blazic016/CNC_ploter/3D print/anti-basculement.stl

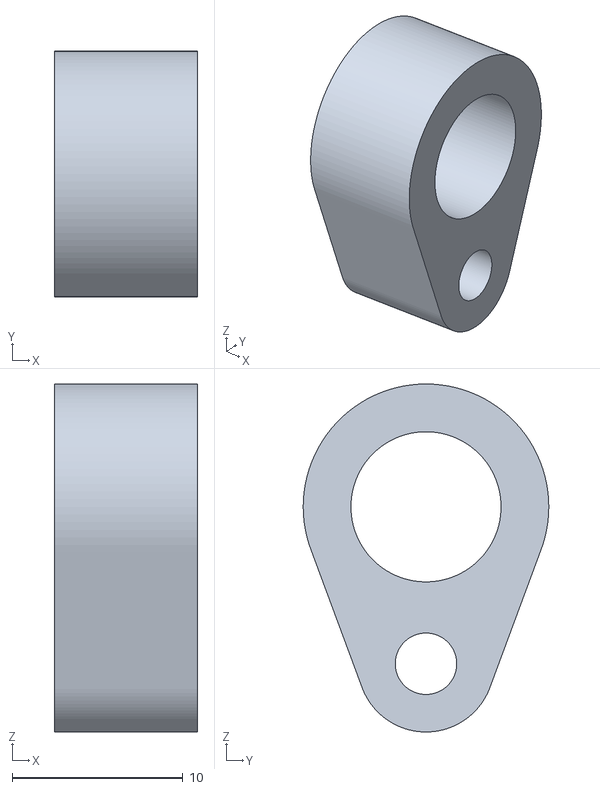
[picture p34: CAD file, 2020-02-16]
3D print/anti-basculement.stl
8.40 x 14.4 x 20.4
