blazic016/CNC_ploter/3D print/porte_crayon.stl

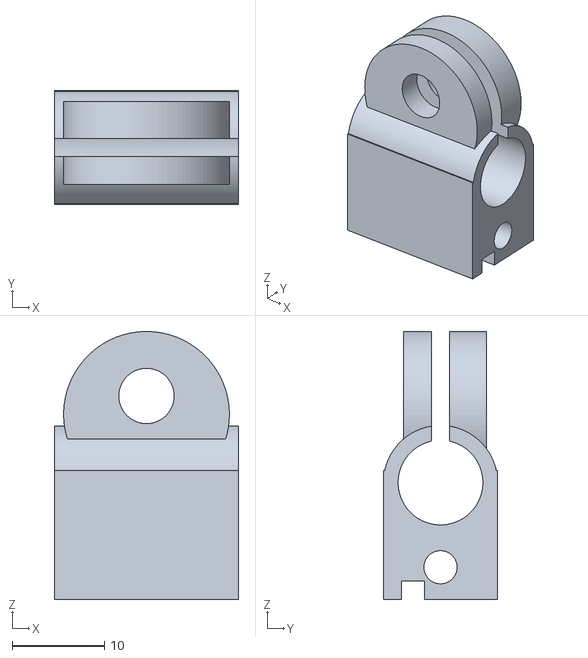
[picture p35: CAD file, 2020-02-16]
3D print/porte_crayon.stl
20.0 x 12.4 x 29.1
