blazic016/CNC_ploter/3D print/support.stl

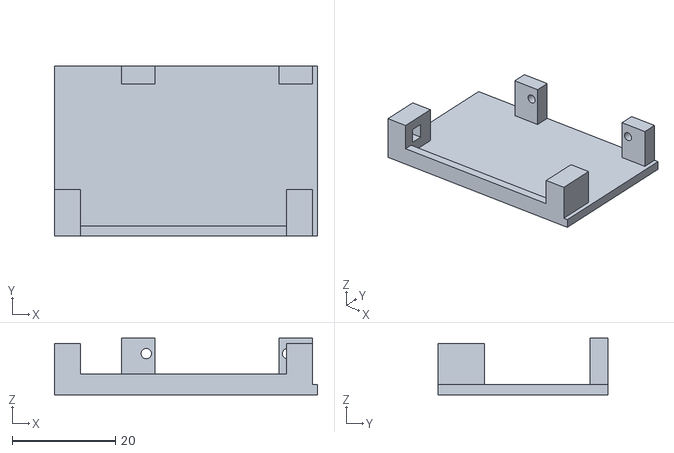
[picture p36: CAD file, 2020-02-16]
3D print/support.stl
51.0 x 33.0 x 11.0
