blazic016/CNC_ploter/Altium/Schematic_CNC.pdf

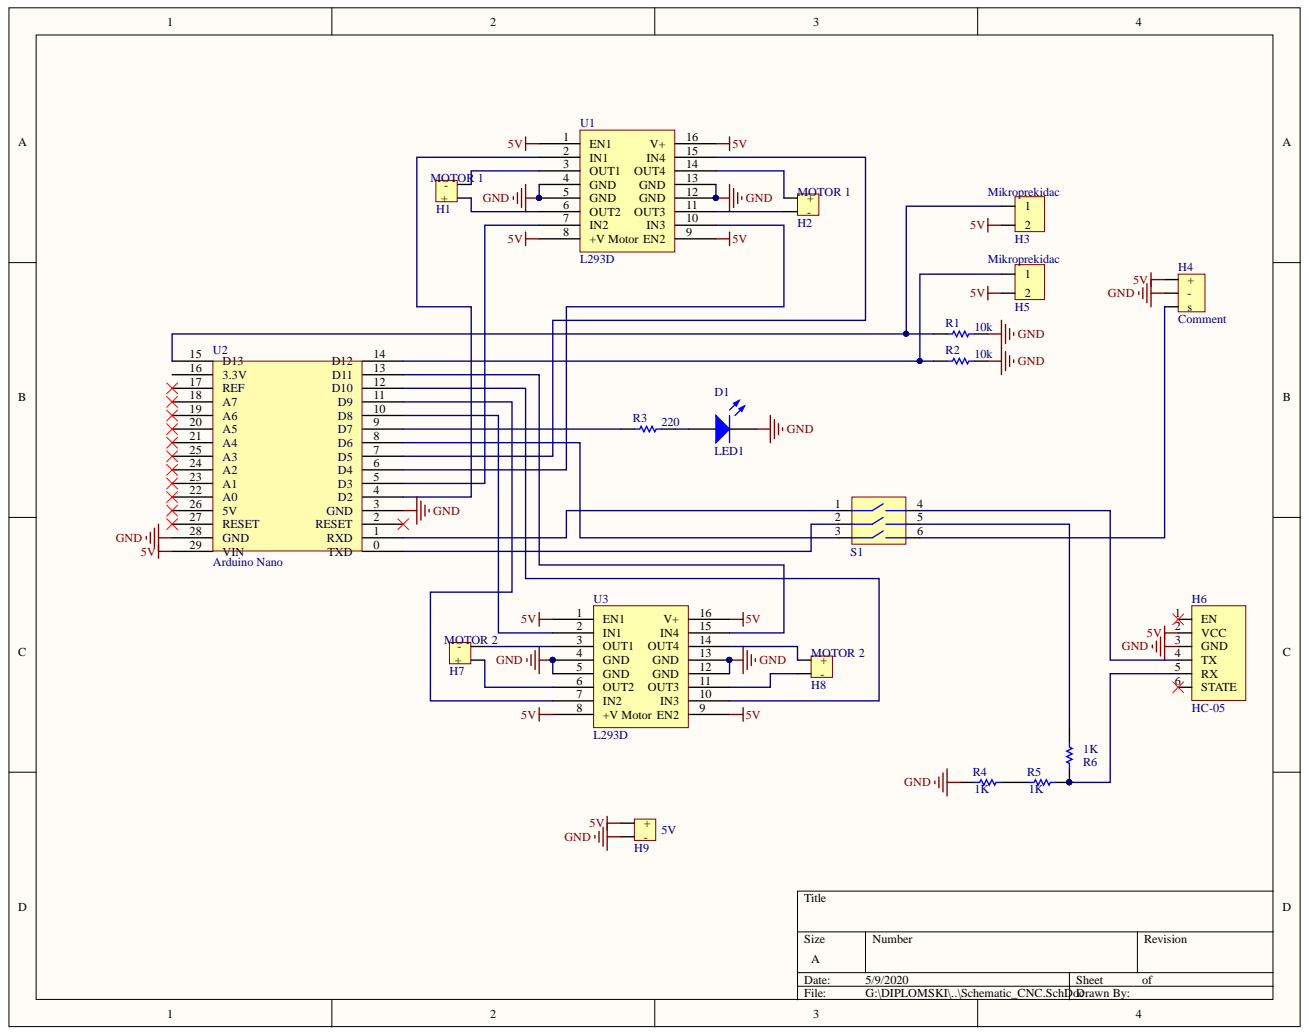
[picture p37: page 1]

OUT1 3
GND 4

-+ | | GND 5

TXD 3.3V 16 | 14 D13 15 | D1

U2 | | | R2 10k
A5 20 | 0 RXD 1 RESET 2 GND 3 D2 4 D3 5 D4 6 D5 7 D6 8 D7 9 D8 10 D9 11 D10 12 D11 13 D12
