blazic016/CNC_ploter/Altium/PCB_CNC.pdf

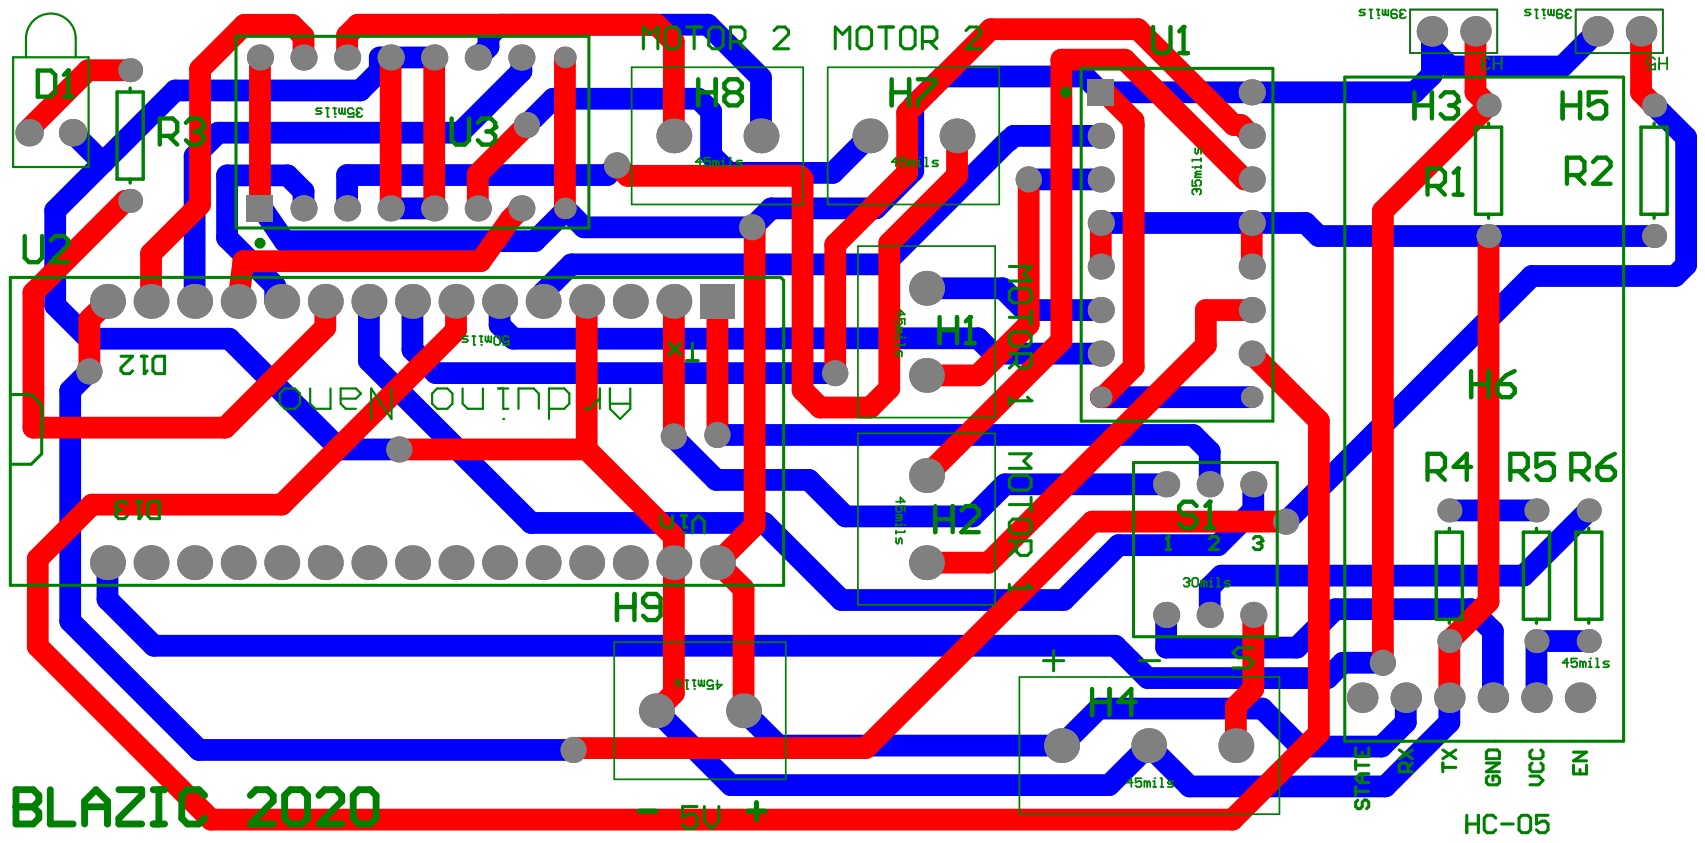
[picture p38: page 1]
