blazic016/CNC_ploter/(list of files, drawings)

Other design files:
Altium/Projekt_Altium_CNC.PrjPCB
Altium/Schematic_CNC.SchDoc
