blazic016/CNC_ploter/(commit log)

2020-02-20 Redesign Schematic and PCB.
    [Projekt_Altium_CNC.PrjPCB, Schematic_CNC.SchDoc]
2020-05-18 Correct bugs for final version
    [Schematic_CNC.SchDoc]
